APM-Kullu/Project/README.md

# Kullu

# Integrantes

- Camilo Andres Vera Ruiz
- Juan Camilo Santana Salgado
- Julián Camilo Velandia
- Santiago Hernández Lamprea

# Planteamiento de Proyecto
[Aqui](./Especificaciones%20de%20Proyecto.pdf) se puede encontrar el documento de especificaciones de los productos que se van a desarrollar.

De igual forma se plantea una [metodología](./Planeacion.md) para la gestión del proyecto.

Automatización de Procesos de Manufactura

Universidad Nacional de Colombia

# [Planta automatizada](./PlantaAutomatizada/PropuestaPlanta.md)
