APM-Kullu/Project/SeleccionMaquinaria/celdaRobótica/gripper_y_ventosas.md

# Selección de una pinza por vacío para agarrar las piezas cortadas de MDF
Para cumplir con la tarea de recoger las piezas de MDF recién cortadas y colocarlas en la siguiente celda, se requiere una pinza por vacío compatible con el brazo robótico de FANUC. La pinza por vacío debe tener la capacidad de agarrar piezas de MDF con un grosor de 15 mm y para las piezas más grandes, con un radio de 45 cm.

Después de evaluar varias opciones, se ha seleccionado la pinza por vacío VGC10 del fabricante On Robot debido a sus características y capacidades.

# Razones de selección
## Capacidad de carga
La pinza por vacío eléctrica VGC10 tiene posibilidades de personalización ilimitadas. También tiene ventosas intercambiables para casi cualquier necesidad de aplicación y Puede levantar objetos de hasta 15 kg.

## Flexibilidad y programabilidad
La pinza por vacío eléctrica VGC10 es compatible con el brazo robótico de FANUC, lo que asegura una fácil integración y compatibilidad. También cuenta con una interfaz de programación intuitiva que facilita la programación y personalización de la tarea. Además, la conectividad de red Ethernet integrada facilita la integración del gripper en sistemas de control de producción más grandes.

[Más información](https://www.roscomponents.com/es/pinzas/292--vgc10-.html)
