APM-Kullu/Project/SeleccionMaquinaria/celdaRobótica/medidas_de_seguridad.md

# Medidas de seguridad en la celda robótica
Es importante tomar medidas de seguridad en la celda robótica para garantizar la seguridad de los trabajadores y el correcto funcionamiento del brazo robótico. A continuación, se describen algunas medidas de seguridad recomendadas para esta celda.

1. Protección de la zona de trabajo
Se debe instalar una barrera de seguridad alrededor de la zona de trabajo para evitar que los trabajadores ingresen accidentalmente en la zona de operación del robot. También se pueden utilizar sensores de presencia para detener el robot en caso de que un trabajador entre en la zona de trabajo.

2. Botón de parada de emergencia
Se debe instalar un botón de parada de emergencia cerca de la zona de trabajo para que los trabajadores puedan detener el robot en caso de una emergencia.

3. Protección del cableado y la alimentación
El cableado y la alimentación del robot deben estar protegidos para evitar cortocircuitos y otros problemas eléctricos. Se pueden utilizar canalizaciones y cubiertas de protección para evitar el acceso no autorizado a los componentes eléctricos.

4. Capacitación de los trabajadores
Es importante capacitar a los trabajadores sobre el funcionamiento y las precauciones de seguridad del brazo robótico. Los trabajadores deben conocer las medidas de seguridad a tomar en caso de emergencia y estar al tanto de los riesgos potenciales de la operación del robot.

5. Mantenimiento regular del robot
El brazo robótico debe recibir un mantenimiento regular para garantizar su correcto funcionamiento y evitar fallos o accidentes. Esto incluye la inspección periódica de los componentes mecánicos y eléctricos, así como la realización de reparaciones y actualizaciones según sea necesario.

6. Cumplimiento de las normativas de seguridad
Es importante asegurarse de cumplir con las normativas de seguridad aplicables en la operación de robots industriales. Esto puede incluir normativas sobre la instalación y uso de robots, así como sobre la capacitación y protección de los trabajadores que operan el robot.
