APM-Kullu/Project/SeleccionMaquinaria/entradas_y_salidas.md

### Entradas, salidas y elementos del tablero de control

- Las entradas son los elementos que se utilizan para recibir información del entorno o del usuario. En este diagrama, las entradas son el botón de emergencia y la fotocélula.
- Los elementos de tablero de control son los elementos que se utilizan para monitorear el sistema y proporcionar información al usuario. En este diagrama, los elementos de tablero de control son el botón de inicio/pausa, las luces de estado y el panel de control HMI.
- Las salidas son los elementos que se utilizan para enviar señales de control al sistema. En este diagrama, las salidas son el motor de seguridad y el motor de movimiento del brazo robótico.
