APM-Kullu/Project/SeleccionMaquinaria/celda_robot.md

## Justificación de la selección de un brazo robótico para la celda robótica
Para la tarea de recoger piezas en MDF recién cortadas con láser y pasarlas a la siguiente celda, se requiere un brazo robótico con un alcance de entre 1.5 y 2 metros y que pueda soportar alrededor de 7 kilos de carga útil. Después de evaluar varias opciones, se ha seleccionado el brazo robótico ABB IRB 2600 debido a sus características y capacidades.

## Razones de selección
### Capacidad de carga
El ABB IRB 2600 tiene una capacidad de carga útil de hasta 12 kilos, lo que es suficiente para manejar la carga de 7 kilos requerida para la tarea. Además, esta capacidad de carga adicional proporciona una margen de seguridad y flexibilidad para futuras aplicaciones o cambios en los requisitos de carga.

### Alcance y precisión
El IRB 2600 tiene un alcance máximo de 1.85 metros, lo que cumple con los requisitos de alcance de la tarea. Además, este brazo robótico cuenta con una precisión de repetición de +/- 0.05 mm, lo que asegura una colocación precisa de las piezas.

### Flexibilidad y programabilidad
El ABB IRB 2600 tiene una amplia gama de movimientos, lo que permite una mayor flexibilidad en la tarea. También cuenta con una interfaz de programación intuitiva que facilita la programación y personalización de la tarea. Además, la conectividad de red Ethernet integrada facilita la integración del robot en sistemas de control de producción más grandes.

## Comparativa con otros 2 robots similares
Para validar la selección del ABB IRB 2600, se comparó con otros dos robots similares en capacidad y alcance: el FANUC LR Mate 200iD y el KUKA KR 6 R900 sixx.

### FANUC LR Mate 200iD
El FANUC LR Mate 200iD tiene una capacidad de carga útil de hasta 7 kilos y un alcance máximo de 0.9 metros. Aunque su capacidad de carga cumple con los requisitos, su alcance es insuficiente para la tarea. Además, su precisión de repetición de +/- 0.02 mm es menor que la del ABB IRB 2600. En cuanto a la programación, FANUC utiliza su propio lenguaje de programación, lo que puede requerir una curva de aprendizaje adicional.

### KUKA KR 6 R900 sixx
El KUKA KR 6 R900 sixx tiene una capacidad de carga útil de hasta 6 kilos y un alcance máximo de 0.9 metros. Al igual que el FANUC LR Mate 200iD, su capacidad de carga es suficiente pero su alcance no cumple con los requisitos de la tarea. Además, su precisión de repetición de +/- 0.03 mm es ligeramente menor que la del ABB IRB 2600. En cuanto a la programación, KUKA utiliza el lenguaje de programación KRL, que puede requerir una curva de aprendizaje adicional.

## Conclusión
Después de evaluar las opciones y comparar el ABB IRB 2600 con otros dos robots similares, se ha determinado que el IRB 2600 es la mejor opción
