APM-Kullu/Project/SeleccionMaquinaria/celdaRobótica/diagrama_seguridad.md

## Medidas de seguridad en la celda con el brazo robótico

El diagrama muestra la disposición de las medidas de seguridad en la celda robótica. El operador está situado fuera de la celda y tiene acceso a un botón de parada de emergencia (E-Stop) y una luz de seguridad que indica el estado del sistema. Dentro de la celda, el controlador del robot está conectado a las alfombras de seguridad que detectan la presencia del operador y detienen el robot si se produce un error.



# Operador
El operador se encuentra fuera de la celda robótica. El operador tiene acceso a un botón de parada de emergencia (E-Stop) y una luz de seguridad que indica el estado del sistema. Estos elementos permiten al operador detener rápidamente el robot en caso de emergencia.

# Robot Controller
Este bloque representa el controlador del robot, que está ubicado dentro de la celda robótica. El controlador se encarga de recibir las órdenes del sistema de control y enviar señales al robot para que realice la tarea programada.

# Robot Controller
Este bloque representa la conexión entre el controlador del robot y las alfombras de seguridad. Las alfombras de seguridad están ubicadas en el suelo de la celda robótica y detectan la presencia del operador. Si el operador entra en la celda robótica, las alfombras de seguridad envían una señal al controlador del robot para detener inmediatamente el movimiento del robot.

# Safety Mats
Este bloque representa las alfombras de seguridad ubicadas en el suelo de la celda robótica. Las alfombras de seguridad detectan la presencia del operador y envían una señal al controlador del robot para detener inmediatamente el movimiento del robot.

# Safety Light
la luz de seguridad está ubicada fuera de la celda robótica. La luz de seguridad indica el estado del sistema y proporciona información al operador sobre el estado del robot y cualquier problema que pueda ocurrir durante la operación.
