APM-Kullu/Project/images/template_down.png

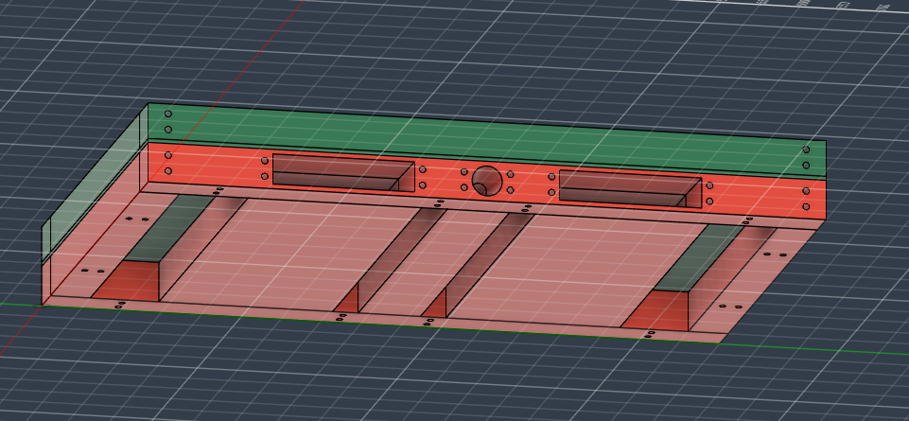
images/template_down.png
