APM-Kullu/Project/(list of files, cad)

Other CAD files:
CAD/Taburete.step
PlantaAutomatizada/CAD/Planta automatizada (v1).step
PlantaAutomatizada/Simulacion/NX/steps/Barriers19.step
PlantaAutomatizada/Simulacion/NX/steps/AligmentTemplates.step
PlantaAutomatizada/Simulacion/NX/steps/Barriers9.step
PlantaAutomatizada/Simulacion/NX/steps/Template4_Void2.step
PlantaAutomatizada/Simulacion/NX/steps/Template1_Drilled.step
PlantaAutomatizada/Simulacion/NX/steps/Template1_PreDrilled.step
PlantaAutomatizada/Simulacion/NX/steps/Barriers12.step
PlantaAutomatizada/Simulacion/NX/steps/Barriers10.step
PlantaAutomatizada/Simulacion/NX/steps/Template4_PreDrilled.step
PlantaAutomatizada/Simulacion/NX/steps/Barriers11.step
PlantaAutomatizada/Simulacion/NX/steps/Barriers14.step
PlantaAutomatizada/Simulacion/NX/steps/Template3_PreDrilled.step
PlantaAutomatizada/Simulacion/NX/steps/Template3_Drilled.step
PlantaAutomatizada/Simulacion/NX/steps/Barriers16.step
PlantaAutomatizada/Simulacion/NX/steps/Template4_Drilled.step
PlantaAutomatizada/Simulacion/NX/steps/Barriers17.step
PlantaAutomatizada/Simulacion/NX/steps/Template2_Drilled.step
PlantaAutomatizada/Simulacion/NX/steps/Barriers20.step
PlantaAutomatizada/Simulacion/NX/steps/Barriers15.step
PlantaAutomatizada/Simulacion/NX/steps/Barriers18.step
PlantaAutomatizada/Simulacion/NX/steps/PlantaAutomatizada.step
PlantaAutomatizada/Simulacion/NX/steps/Template2_PreDrilled.step
PlantaAutomatizada/Simulacion/NX/steps/Barriers13.step
PlantaAutomatizada/Simulacion/NX/steps/Template4_Void.step
PlantaAutomatizada/CAD/MecanismoTaladrado v33.f3z
PlantaAutomatizada/CAD/MordazaNeumatica v28.f3d
PlantaAutomatizada/CAD/PiezasYCortes v44.f3z
PlantaAutomatizada/CAD/PlantaAutomatizada2 v43.f3z
PlantaAutomatizada/CAD/Plantillas_Taladrado.f3d
PlantaAutomatizada/Simulacion/NX/#_RSAUW-B-3069-P11-190607-0207.prt
PlantaAutomatizada/Simulacion/NX/300720_01.prt
PlantaAutomatizada/Simulacion/NX/300727_01.prt
PlantaAutomatizada/Simulacion/NX/300728_01.prt
PlantaAutomatizada/Simulacion/NX/300731_01.prt
PlantaAutomatizada/Simulacion/NX/300731_01_1.prt
PlantaAutomatizada/Simulacion/NX/300733_01.prt
PlantaAutomatizada/Simulacion/NX/300733_01_1.prt
PlantaAutomatizada/Simulacion/NX/300748_01 (10).prt
PlantaAutomatizada/Simulacion/NX/300748_01 (10)_1.prt
PlantaAutomatizada/Simulacion/NX/300748_01 (11).prt
PlantaAutomatizada/Simulacion/NX/300748_01 (11)_1.prt
PlantaAutomatizada/Simulacion/NX/300748_01 (9).prt
PlantaAutomatizada/Simulacion/NX/300748_01 (9)_1.prt
PlantaAutomatizada/Simulacion/NX/300748_01 (9)_2.prt
PlantaAutomatizada/Simulacion/NX/300749_01.prt
PlantaAutomatizada/Simulacion/NX/300749_01_1.prt
PlantaAutomatizada/Simulacion/NX/300750_01 (3).prt
PlantaAutomatizada/Simulacion/NX/300750_01 (3)_1.prt
PlantaAutomatizada/Simulacion/NX/300750_01 (3)_2.prt
PlantaAutomatizada/Simulacion/NX/300750_01 (3)_3.prt
PlantaAutomatizada/Simulacion/NX/300751_01.prt
PlantaAutomatizada/Simulacion/NX/300751_01_1.prt
PlantaAutomatizada/Simulacion/NX/300752_01.prt
PlantaAutomatizada/Simulacion/NX/300752_01_1.prt
PlantaAutomatizada/Simulacion/NX/300753_01 (3).prt
PlantaAutomatizada/Simulacion/NX/300753_01 (3)_1.prt
PlantaAutomatizada/Simulacion/NX/300755_01 (10).prt
PlantaAutomatizada/Simulacion/NX/300755_01 (10)_1.prt
PlantaAutomatizada/Simulacion/NX/300755_01 (10)_2.prt
PlantaAutomatizada/Simulacion/NX/300755_01 (10)_3.prt
PlantaAutomatizada/Simulacion/NX/300755_01 (11).prt
PlantaAutomatizada/Simulacion/NX/300755_01 (11)_1.prt
PlantaAutomatizada/Simulacion/NX/300755_01 (11)_2.prt
PlantaAutomatizada/Simulacion/NX/300755_01 (11)_3.prt
PlantaAutomatizada/Simulacion/NX/300755_01 (11)_4.prt
PlantaAutomatizada/Simulacion/NX/300755_01 (9).prt
PlantaAutomatizada/Simulacion/NX/300755_01 (9)_1.prt
PlantaAutomatizada/Simulacion/NX/300755_01 (9)_2.prt
PlantaAutomatizada/Simulacion/NX/300755_01 (9)_3.prt
PlantaAutomatizada/Simulacion/NX/3080A18_Drill Bit for Wood Screws.prt
PlantaAutomatizada/Simulacion/NX/60405K127_Enclosed-Body NFPA Tie Rod Air Cylinder.prt
PlantaAutomatizada/Simulacion/NX/6627T103_Stepper Motor.prt
PlantaAutomatizada/Simulacion/NX/6734K816_Motor-Mount Positioning Slide.prt
PlantaAutomatizada/Simulacion/NX/6734K817_Motor-Mount Positioning Slide.prt
PlantaAutomatizada/Simulacion/NX/6734K818_Motor-Mount Positioning Slide.prt
PlantaAutomatizada/Simulacion/NX/6734K821_Motor-Mount Positioning Slide.prt
PlantaAutomatizada/Simulacion/NX/68507_01 (18).prt
PlantaAutomatizada/Simulacion/NX/68507_01 (19).prt
PlantaAutomatizada/Simulacion/NX/68507_01 (20).prt
PlantaAutomatizada/Simulacion/NX/68507_01 (21).prt
PlantaAutomatizada/Simulacion/NX/68507_01 (22).prt
PlantaAutomatizada/Simulacion/NX/68507_01 (23).prt
PlantaAutomatizada/Simulacion/NX/8379K12_Telescoping Slide.prt
PlantaAutomatizada/Simulacion/NX/AM_LDA_06x62_R.prt
PlantaAutomatizada/Simulacion/NX/AM_LDA_06x62_R_1.prt
PlantaAutomatizada/Simulacion/NX/AR22E0R_Contact_Unit_Base.prt
PlantaAutomatizada/Simulacion/NX/AR22E0R_Contact_Unit_Base2.prt
PlantaAutomatizada/Simulacion/NX/AR22F0R_Control_Unit.prt
PlantaAutomatizada/Simulacion/NX/AR22F0R_Control_Unit_Asm.prt
PlantaAutomatizada/Simulacion/NX/AR22F0R_Control_Unit_Asm2.prt
PlantaAutomatizada/Simulacion/NX/AR22F0R_Switch.prt
PlantaAutomatizada/Simulacion/NX/AR22F0R_Switch2.prt
PlantaAutomatizada/Simulacion/NX/AR22F0RのSTEPファイル.prt
PlantaAutomatizada/Simulacion/NX/AR22F0RのSTEPファイル2.prt
PlantaAutomatizada/Simulacion/NX/AR22PCR_Control_Unit.prt
PlantaAutomatizada/Simulacion/NX/AR22PCR_Control_Unit_Asm (1).prt
PlantaAutomatizada/Simulacion/NX/AR22PCR_Control_Unit_Asm (2).prt
PlantaAutomatizada/Simulacion/NX/AR22PCR_Control_Unit_Asm (3).prt
PlantaAutomatizada/Simulacion/NX/AR22PCR_Control_Unit_Asm (4).prt
PlantaAutomatizada/Simulacion/NX/AR22PCR_Control_Unit_Asm (5).prt
PlantaAutomatizada/Simulacion/NX/AR22PCR_Control_Unit_Asm (6).prt
PlantaAutomatizada/Simulacion/NX/AR22PCR_Control_Unit_Asm (7).prt
PlantaAutomatizada/Simulacion/NX/AR22PCR_Control_Unit_Asm.prt
PlantaAutomatizada/Simulacion/NX/AR22PR-2のSTEPファイル (1).prt
PlantaAutomatizada/Simulacion/NX/AR22PR-2のSTEPファイル (2).prt
PlantaAutomatizada/Simulacion/NX/AR22PR-2のSTEPファイル (3).prt
PlantaAutomatizada/Simulacion/NX/AR22PR-2のSTEPファイル (4).prt
PlantaAutomatizada/Simulacion/NX/AR22PR-2のSTEPファイル (5).prt
PlantaAutomatizada/Simulacion/NX/AR22PR-2のSTEPファイル (6).prt
PlantaAutomatizada/Simulacion/NX/AR22PR-2のSTEPファイル (7).prt
PlantaAutomatizada/Simulacion/NX/AR22PR-2のSTEPファイル.prt
PlantaAutomatizada/Simulacion/NX/AR9M006.prt
PlantaAutomatizada/Simulacion/NX/AR9M006_Cover.prt
PlantaAutomatizada/Simulacion/NX/AR9R744.prt
PlantaAutomatizada/Simulacion/NX/AS_BCS2_141107 (1).prt
PlantaAutomatizada/Simulacion/NX/AS_BCS2_141107 (2).prt
PlantaAutomatizada/Simulacion/NX/AS_BCS2_141107 (3).prt
PlantaAutomatizada/Simulacion/NX/AS_BCS2_141107 (4).prt
PlantaAutomatizada/Simulacion/NX/AS_BCS2_141107 (5).prt
PlantaAutomatizada/Simulacion/NX/AS_BCS2_141107 (6).prt
PlantaAutomatizada/Simulacion/NX/AS_BCS2_141107 (7).prt
PlantaAutomatizada/Simulacion/NX/AS_BCS2_141107.prt
PlantaAutomatizada/Simulacion/NX/Adjustable handles ERM.95 A-M12-C2_01.prt
PlantaAutomatizada/Simulacion/NX/Adjustable handles ERM.95 A-M12-C2_01_1.prt
PlantaAutomatizada/Simulacion/NX/AligmentTemplates.prt
PlantaAutomatizada/Simulacion/NX/BCS2_141107.prt
PlantaAutomatizada/Simulacion/NX/Barriers10.prt
PlantaAutomatizada/Simulacion/NX/Barriers11.prt
PlantaAutomatizada/Simulacion/NX/Barriers12.prt
PlantaAutomatizada/Simulacion/NX/Barriers13.prt
PlantaAutomatizada/Simulacion/NX/Barriers14.prt
PlantaAutomatizada/Simulacion/NX/Barriers15.prt
PlantaAutomatizada/Simulacion/NX/Barriers16.prt
PlantaAutomatizada/Simulacion/NX/Barriers17.prt
PlantaAutomatizada/Simulacion/NX/Barriers18.prt
PlantaAutomatizada/Simulacion/NX/Barriers19.prt
PlantaAutomatizada/Simulacion/NX/Barriers20.prt
PlantaAutomatizada/Simulacion/NX/Barriers21.prt
PlantaAutomatizada/Simulacion/NX/Barriers8.prt
PlantaAutomatizada/Simulacion/NX/Barriers9.prt
PlantaAutomatizada/Simulacion/NX/Base-Universal-1.prt
PlantaAutomatizada/Simulacion/NX/Base-Universal-121386.prt
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
