APM-Kullu/Project/PlantaManual/equipos.md

# Equipos y Herramientas de planta no automatizada

## Materia prima (Lámina de MDF 15 mm) 

La materia prima es una lámina de MDF de 15 mm de espesor y de dimensiones 1.8 m x 2.4 m. La referencia de la lámina es [Lámina de MDF](https://colombia.masisa.com/producto/mdf/).



Las láminas son vendidas por Masisa  Colombia, hace falta una cotización al por mayor (Cuantas).

<!-- -------------------------------------------------------------------------------------------------------------------------------------------------------- -->
## Corte previo de lámina 

Para cortar MDF se requiere de una sierra industrial, en este caso se hará una estación de corte con una sierra circular de mano. Se puede utilizar una sierra circular con una potencia mínima de 1200W y una velocidad de al menos 4500 RPM. Sin embargo, es importante tener en cuenta que la capacidad de corte (15 mm) también dependerá del diámetro de la hoja de sierra, la calidad y el tipo de la hoja de sierra, así como de la velocidad de alimentación del material. En general, se recomienda utilizar una hoja de sierra con un número de dientes adecuado para cortar MDF, que puede variar de 40 a 80 dientes. También es importante asegurarse de que la hoja de sierra esté afilada y en buen estado para garantizar un corte limpio y preciso.

Para esta etapa se escogió la maquina [Sierra Circular 7-1/4-pulg 1500W 6000RPM GKS 150](https://homecenterco.scene7.com/is/image/SodimacCO/358623_1?fmt=jpg&fit=fit,1&wid=420&hei=420).



La máquina ruteadora es vendida por Homecenter, al ser una compra nacional solo se tiene en cuenta el precio mismo de la máquina: **COP 649.900**.  

<!-- -------------------------------------------------------------------------------------------------------------------------------------------------------- -->
## Corte láser

Para elegir la máquina de corte láser adecuada, es necesario conocer las dimensiones de la lámina a cortar (**1200 x 900 mm**) y en base a ellas, seleccionar el área 
de trabajo necesaria en la máquina. Otro criterio importante a considerar es la potencia de la máquina, ya que esto determina la profundidad de corte. En este caso, 
se requieren cortes de al menos 15 milímetros de profundidad, lo que implica la necesidad de una máquina de corte con una potencia de al menos **150 Watts**.

Para esta etapa se escogió esta [máquina de corte laser](https://es.made-in-china.com/co_starmacnc/product_Over-15mm-Thickness-MDF-Wood-Acrylic-Cutting-Laser-Cutting-Machine-with-150W_eguhionyy.html).



El precio FOB (Free on Board) está entre **USD 5.200-6.000** dependiendo del tamaño de la máquina. 
(Precio concreto pendiente)

<!-- -------------------------------------------------------------------------------------------------------------------------------------------------------- -->
## Taladrado

Para realizar perforaciones en MDF, es necesario contar con un taladro de banco de nivel industrial (sobremesa o pie), ya que se requerirá una alta intensidad de uso. 
Generalmente, para perforar MDF no se necesita una gran potencia de taladro. Un taladro con una potencia de **500 a 700 Watts** debería ser suficiente para perforar MDF 
con brocas para madera estándar. Lo más importante es usar la broca adecuada. Para MDF, se recomienda una broca para madera con una punta de centrado y una geometría 
de corte que permita una perforación limpia. Se recomienda utilizar un taladro con una broca de punta de carburo, ya que son más duras y resistentes que las brocas de 
acero de alta velocidad y pueden perforar materiales más duros sin desgastarse rápidamente. Además, para perforar MDF no es necesario un taladro con transmisión de 
engranajes, ya que un taladro con transmisión de correa puede ser suficiente y su mantenimiento es más sencillo.

Para esta etapa se escogió el [Taladro de columna B 24 H (400V)](https://www.aslak.es/metal/3020243-taladro-de-columna-b-24-h-400v.html).



El precio FOB (Free on Board) es **EUR 1.759**.

<!-- -------------------------------------------------------------------------------------------------------------------------------------------------------- -->
## Acabado

Para realizar el acabado se usará una maquina ruteadora portatil de tipo industrial:
[Ruteadora Industrial 1800w 2.4hp 15amp](https://www.homecenter.com.co/homecenter-co/product/336547/ruteadora-industrial-24hp-1800w-15amp-vv/336547/).



La máquina ruteadora es vendida por Homecenter, al ser una compra nacional solo se tiene en cuenta el precio mismo de la máquina: **COP 535.900**.  

<!-- -------------------------------------------------------------------------------------------------------------------------------------------------------- -->
## Tornillos

Para agujeros de 4.2 mm de diámetro se necesitan tornillos para madera de calibre 8, en su mayoría serán 8 x 2”, pero hay unas excepciones y se usarán 8 x 1-¼”

- [Tornillo Aglomerado Autoperforante 8X2](https://www.homecenter.com.co/homecenter-co/product/86579/tornillo-aglomerado-autoperforante-8x2-100un/86579/).

- [Tornillo Aglomerado Autoperforante 8X1-1/4](https://www.homecenter.com.co/homecenter-co/product/86575/tornillo-aglomerado-autoperforante-8x1-1-4-100un/86575/).

Los tornillos necesarios son vendidos por Homecenter, al ser una compra nacional solo se tiene en cuenta el precio mismo de los tornillos, para saber el costo total
sería necesario conocer la cantidad de piezas que se realizarán por día, los precios por paquetes de 100 unidades son **COP 9.800** y **COP 6800** respectivamente.

(Hace falta cotizar tornillos al por mayor)
