APM-Kullu/Project/PlantaManual/etapas.md

# Etapas en el proceso de fabricación de piezas de MDF

El proceso de fabricación de piezas de MDF (tablero de fibra de densidad media) incluye varias etapas, desde el corte láser hasta el almacenamiento. En este documento se describirán las diferentes etapas del proceso en el orden en que se realizan.
Las piezas a desarrollar son una estantería de vinos, un taburete y una base para un computador portátil.

## 1. Suministro de láminas de MDF mediante montacargas

(1 operario)
El proceso de suministro de paquetes de láminas de MDF mediante un montacargas implica los siguientes pasos:

1. Preparación del área de carga: antes de que llegue el montacargas con los paquetes de láminas de MDF, se debe preparar el área de carga para recibir la carga. Esto puede incluir la limpieza del área y la colocación de las barreras de seguridad necesarias para proteger a los trabajadores y las instalaciones.

2. Descarga del montacargas: cuando llega el montacargas con los paquetes de láminas de MDF, el conductor debe detener el vehículo en el área de carga y asegurarse de que el freno de mano esté activado. A continuación, se procede a descargar la carga del vehículo.

3. Ubicación de los paquetes: una vez que se han descargado los paquetes de láminas de MDF del montacargas, se deben ubicar en la zona de almacenamiento correspondiente. Esta zona de almacenamiento debe estar previamente designada y organizada para facilitar la ubicación de los paquetes.

4. Verificación de la cantidad y calidad: antes de proceder a utilizar las láminas de MDF en el proceso de fabricación, se debe verificar la cantidad y calidad de los paquetes suministrados. Esto implica contar las láminas y asegurarse de que no estén dañadas o rotas.

5. Transporte de las láminas: una vez que se han verificado los paquetes de láminas de MDF, se procede a transportarlas al área de producción. Esto puede implicar el uso de carretillas elevadoras o equipos de transporte especializados.

6. Las láminas comerciales son muy grandes para entrar en la máquina de corte laser, por lo que estas se deben cortar en 4 partes con una sierra de mesa por parte del operario del área.

Cabe resaltar que el proceso anterior lo realiza un mismo operario y pasa las láminas ya cortadas por un buffer o cinta transportadora, para la siguiente etapa

## 2. Corte láser

(1 operario)
El segundo paso se realiza por un operario que suministra las láminas de MDF en la máquina de corte láser. Para lograr una precisión óptima en el corte, se utiliza un láser de alta precisión que corta las piezas de MDF de acuerdo con las especificaciones de diseño, lo que reduce los residuos y el desperdicio de material.

Para llevar a cabo el corte láser, se realizó una simulación en el software Fusion 360 a partir del plano CAD de todas las piezas. Sin embargo, aún existe incertidumbre en cuanto a la velocidad de corte real de la máquina seleccionada, debido a que los parámetros exactos de la misma no se encuentran disponibles en la página del proveedor. Por lo tanto, se seleccionó un parámetro de potencia y se obtuvo una estimación de la velocidad de corte a través de la web MantechMachinery. La simulación, junto con los planos de corte y el modelo CAD de las tres piezas, se encuentra disponible en el archivo "corteLaser.f3d".

Para llevar a cabo el corte láser se utiliza una lámina de MDF de 1300 mm x 900 mm x 15 mm como entrada, y se obtienen como salida las piezas individuales para armar 1 taburete, 1 portavinos y 2 bases para PC. El tiempo total estimado para este proceso es de 1:29 minutos.

Las lámina a cortar tienen las siguientes medidas: 1200 x 900 mm. La máquina de corte cuenta con una potencia de al menos 150 W.

## 3. Separación de piezas

(1 operario)
El tercer paso en el proceso de fabricación de las piezas de MDF es la separación de las piezas cortadas. Este paso se realiza por un operario que se encarga de retirar las piezas cortadas del tablero principal y clasificarlas según su tamaño.

El operario toma las piezas cortadas y las separa en dos grupos, uno para las piezas grandes y otro para las piezas pequeñas. Cada grupo se introduce en su respectivo buffer para pasar al siguiente paso en el proceso de fabricación, que es el área de fresado.

Es importante destacar que la separación de las piezas según su tamaño es un paso crítico para asegurar la eficiencia. Toma Al rededor de 1:30 minutos por placa que entrega la máquina de corte. Además, la separación de las piezas grandes y pequeñas permite un mejor control de la producción y una organización más eficiente del flujo de trabajo.

## 4. Fresado

(2 operario)
Después de separar las piezas, se realiza el fresado. Este proceso implica dar forma a las piezas y cortar cualquier exceso de material que pueda haber quedado después del corte láser. El fresado se realiza con una máquina fresadora de esquinas que acciona el operario del área. Luego se separan en un buffer individual por cada pieza.
Este proceso tarda al rededor de 10 minutos y se realiza por 2 operarios

## 5. Taladrado

(2 operario)
El proceso de taladrado comienza después de que las piezas se han separado por tamaño, han pasado por el proceso de fresado y se han introducido en dos buffers diferentes. El operario comienza por hacer agujeros en las piezas según las especificaciones de diseño utilizando una máquina taladradora de banco y una máquina taladradora con sierra de copa, según los requerimientos de cada pieza.

Una vez que se han taladrado todas las piezas, el operario las pasa por una banda transportadora para el sellado por aerosol. En este punto, el operario debe usar un compresor para limpiar la pieza de viruta antes de proceder con el sellado.

Para realizar el taladrado en MDF, se necesita un taladro de banco de nivel industrial (sobremesa o pie), ya que se requerirá una alta intensidad de uso. Por lo general, para perforar MDF no se necesita una gran potencia de taladro, y un taladro con una potencia de 500 a 700 Watts debería ser suficiente para perforar MDF con brocas para madera estándar. Es importante utilizar la broca adecuada, y para MDF se recomienda una broca para madera con una punta de centrado y una geometría de corte que permita una perforación limpia. Además, es recomendable utilizar un taladro con una broca de punta de carburo, ya que son más duras y resistentes que las brocas de acero de alta velocidad y pueden perforar materiales más duros sin desgastarse rápidamente.

Para esta etapa del proceso se ha seleccionado el taladro de columna B 24 H (400V), y se estima que el proceso de taladrado con dos operarios tomará alrededor de 6 minutos y 30 segundos en completarse.

## 6. Sellado por aerosol

(1 operario)
Una vez que se han cortado, separado, fresado y taladrado las piezas de MDF, se procede al sellado por aerosol. Este proceso implica aplicar una capa de sellador de aerosol sobre las piezas. El sellador ayuda a proteger la superficie de la pieza.

El tiempo que se requiere para realizar el sellado por aerosol de cada pieza depende del tamaño de las mismas, pero en promedio se estima que toma alrededor de 1 minuto por pieza. Una vez que se ha aplicado el sellador, después, un operario pone a secar las piezas en un almacén por un promedio de 4 horas, para asegurar que el sellante quede bien aplicado.

## 7. Ensamble

(2 -3 operarios)
El siguiente paso es el ensamblaje de las piezas. Este proceso implica unir las diferentes piezas según el diseño, para esto, un operario las separa por el tipo de producto (Estantería, taburete y base) y entre 2 o 3 operarios (Dependiendo del volumen de producción), se realiza en ensamblaje del producto por medio de tornillería, al cual para perforar agujeros de 4.2 mm de diámetro en las piezas de MDF, se requieren tornillos para madera de calibre 8. La mayoría de los tornillos necesarios son de 8 x 2", pero para algunas piezas se necesitarán tornillos de 8 x 1-¼". Los proovedores nacionales (Ver sección Tornillos de Equipos) venden los tornillos necesarios para este proceso, y el precio de cada paquete de 100 unidades es de COP 9.800 para los tornillos de 8 x 2" y COP 6.800 para los tornillos de 8 x 1-¼". El costo total dependerá de la cantidad de piezas que se realicen por día. Cabe destacar que estos precios corresponden a una compra nacional de los tornillos.

## 8. Lacado

(1 operario)
Después del ensamblaje, se procede al lacado de las piezas. Este proceso implica aplicar una capa de laca sobre las piezas. La laca ayuda a proteger la superficie de la pieza y a darle un acabado suave y brillante. El lacado se realiza con una pistola de pintura y puede requerir varias capas, dependiendo del diseño y del acabado deseado.

## 9. Almacenaje

(1 operario)
Una vez que se han lacado todas las piezas, se procede al almacenamiento.
Primero se almacenan en un almacén de secado, donde las piezas deben permanecer un tiempo estipulado, para asegurar que el lacado se fijó correctamente, luego se almacenan en un almacén de despacho, donde se surten a los transportistas para la entrega al cliente final.
El almacenamiento adecuado ayuda a proteger las piezas de la humedad y del polvo, lo que puede dañar la superficie.

# Diagrama del proceso

Diagrama de planta no automatizada
