APM-Kullu/Project/(threads)

Thread 2 (2023-02-26):

2.1 CAD de los 3 productos

caverar, 2023-02-26:

caverar, 2023-02-26:
Terminado, solo falta que todos suban el archivo al repo.

caverar, 2023-02-28:
Pendiente Julián y Juan por subir archivo.  Julián importante corregir unidades del archivo. IMPORTANTE: formato .step único archivo de ensamble debido a que nos contabilizaran el porcentaje de aporte de cada uno mediante GitHub.

julianVelandia, 2023-02-28:
Los archivos de las piezas de la estantería de vinos ya se encontraban en la carpeta de Drive (Al igual que los del compañero Juan), sin embargo se sube una carpeta con los archivos .STEP, .DWG y .PDF con la convención de medidas acordada

Closed 2023-03-26.

Thread 5 (2023-02-26):

Organización de plantilla para web de proyecto

caverar, 2023-02-26:

caverar, 2023-02-28:
Finalizar a mas tardar el miércoles 1 de marzo, teniendo en cuenta otras paginas como: https://art3chautomation.github.io/WarePatch/Home.html, https://leonardomercado.github.io/Proyecto_APM/03%20Pagina%20web/index.html, https://apm2021-1.github.io/BICIBU-Pagina-web/

julianVelandia, 2023-02-28:
Ya se había subido una primera y desplegado una primera versión, sin embargo, se subieron más cambios con las referencias anteriores [PR](https://github.com/APM-Kullu/kulluWebSite/pull/1)

Closed 2023-02-28.

Thread 7 (2023-02-26):

2.2.1 Selección de etapas de planta no automatizada

caverar, 2023-02-26:

caverar, 2023-02-28:
Reunirse entre Santiago y Julián, alistar borrador de planta al finalizar esta semana para mostrar a profesor.  #10

caverar, 2023-03-09:
Propuesta inicial planteada por Santiago y Julian disponible [aqui](lucid.app/lucidchart/2d4ed129-ebc9-4bea-b457-dee5d30df799/edit)  Completada por Juan Y Camilo durante reunión. pendientes los tiempos de cada etapa.

Closed 2023-03-26.

Thread 39 (2023-03-26):

2.2.4 Diseño de planos de manufactura

caverar, 2023-03-26:

caverar, 2023-03-26:
Diseño disponible en Fusion360 junto simulación de corte laser disponible [aqui](https://github.com/APM-Kullu/Project/blob/main/PlantaManual/SimulacionCorteLaser.f3d)

Closed 2023-03-26.
