APM-Kullu/Project/(commit log)

2023-03-29 Update README.md
    error en el readme
2023-04-01 Mejoras en el proceso
2023-04-04 added footpaths and object names
    Added footpaths. Found that there might be an unnecessary conveyor belt after drying station. This belt is not included in the model.
2023-04-10 Plantilla taladrado
    [Plantillas_Taladrado.f3d]
2023-06-01 git lfs config
    [Taburete.step]
2023-06-01 Etiquetas de entradas y salidas
    [IOS.xlsx]
2023-06-01 Proyecto NX
    [#_RSAUW-B-3069-P11-190607-0207.prt, 300720_01.prt, 300727_01.prt, 300728_01.prt, 300731_01.prt, 300731_01_1.prt, 300733_01.prt, 300733_01_1.prt]
2023-06-01 CAD Mecanismo de taladrado
    [MecanismoTaladrado v33.f3z, Plantillas_Taladrado.f3d]
2023-06-01 CAD Mecanismo de mordaza neumatica
    [MordazaNeumatica v28.f3d]
2023-06-01 Piezas y simulaciones de corte CNC y laser
    [PiezasYCortes v44.f3z]
2023-06-01 CAD Planta automatizada
    [Planta automatizada (v1).step, PlantaAutomatizada2 v43.f3z]
2023-06-04 Plantillas de transporte de piezas
2023-06-05 Create Drivers y Motores (Motion Control)
2023-06-05 Update Drivers y Motores (Motion Control)
2023-06-05 Rename Drivers y Motores (Motion Control) to Drivers y Motores (Motion Control).md
2023-06-05 Update Drivers y Motores (Motion Control).md
